Chinmaisoorya/smart-dc-load-controller/preview.webp

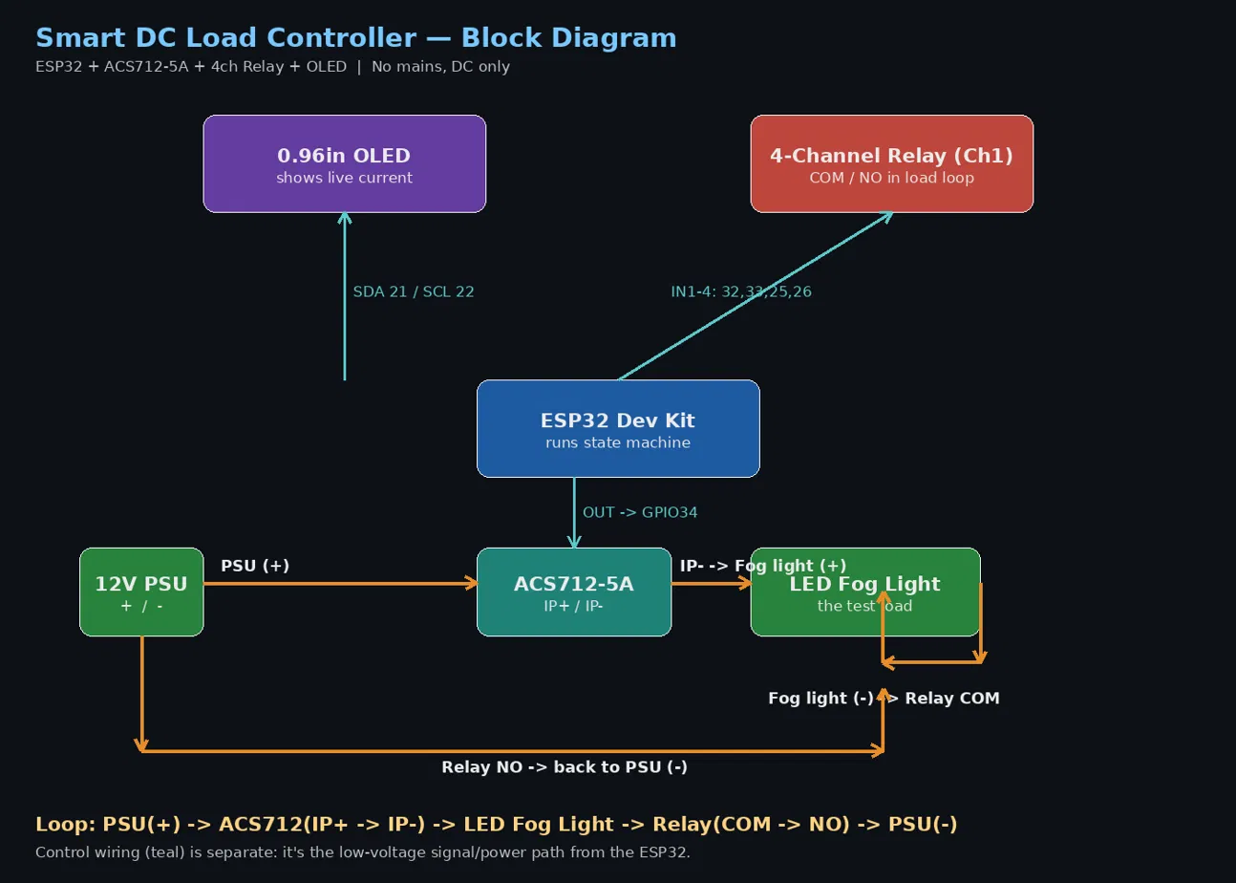
preview.webp
